versioduo/express/hardware/README.md

# express
🎚️ MIDI Expression Controller

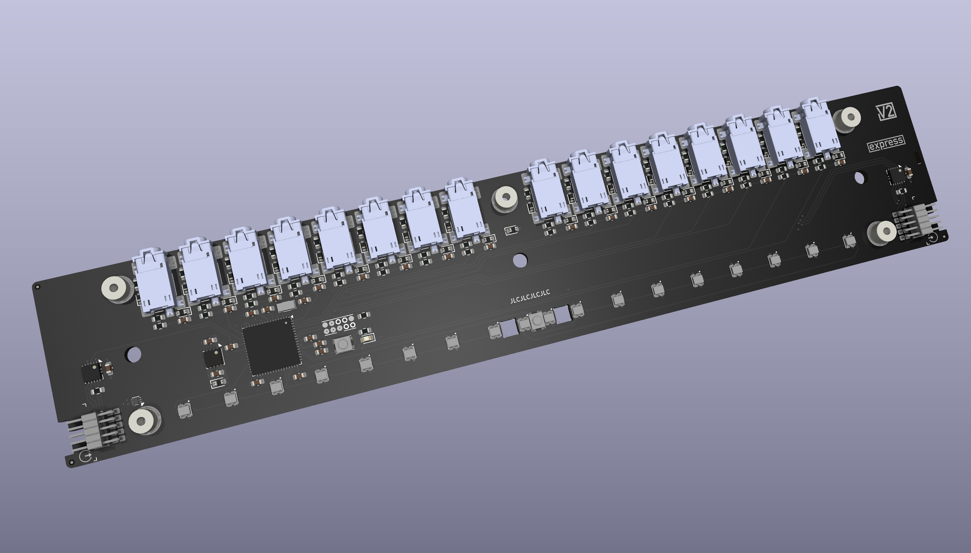
[picture p1: hardware/express-board.png]
board


## Schematic
[PDF](express.pdf)

## Bill Of Materials
[Interactive BOM](https://html-preview.github.io/?url=https://github.com/versioduo/express/main/hardware/express-bom.html)

# Copying
Anyone can use this public domain work without having to seek authorisation, no one can ever own it.
