versioduo/express/hardware/express.kicad_pcb

## KiCad design hardware/express.kicad_pcb (2026-04-15)

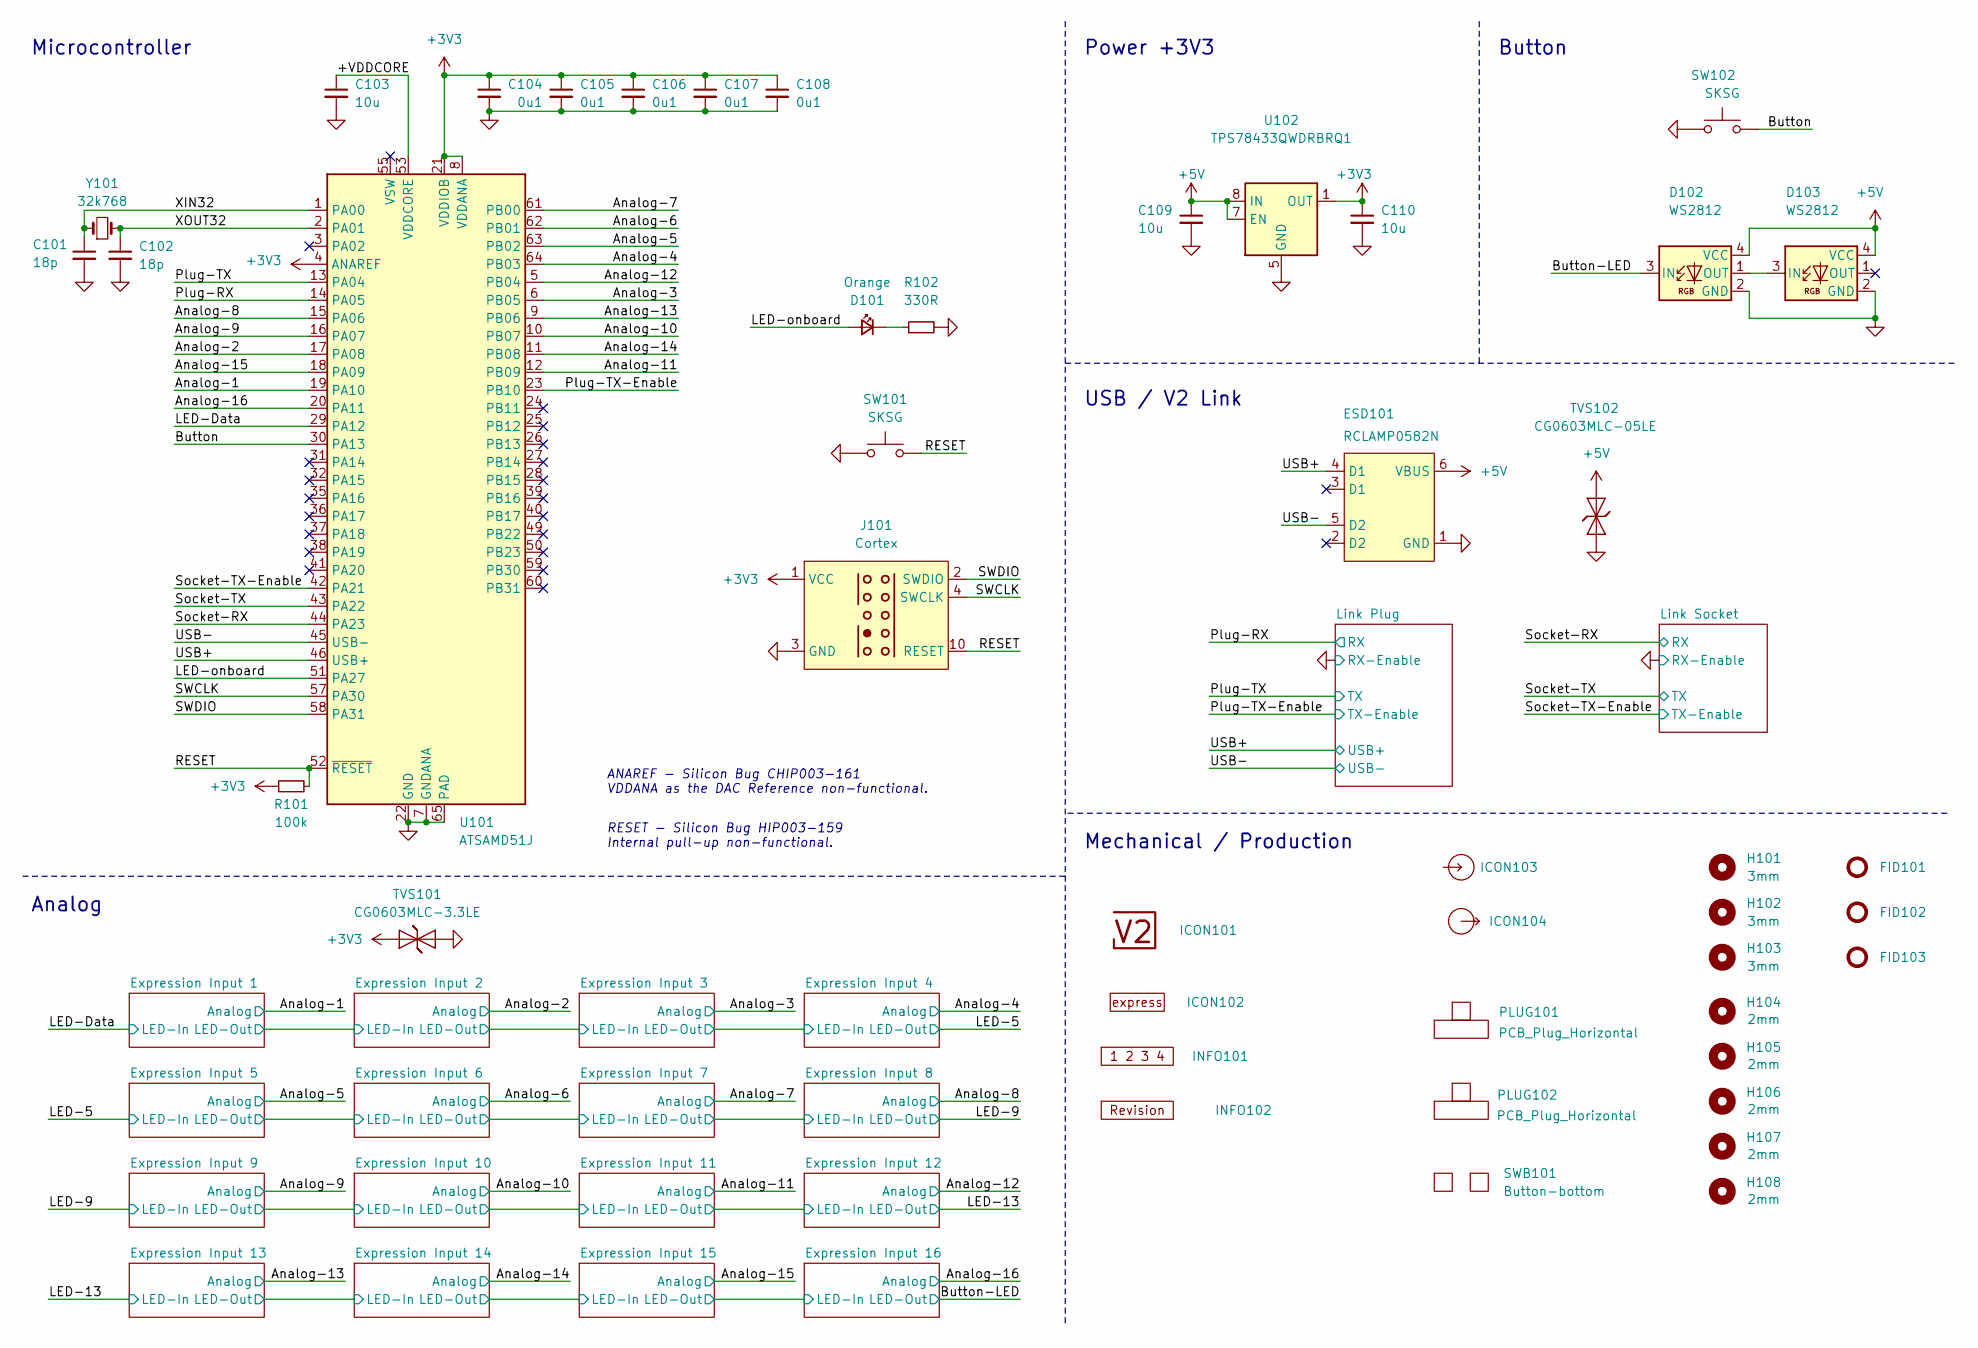
[picture p22: schematic express.kicad_sch, V2 express]

Parts:
C101, C102: 18p; C_0603; Rating 50V; Mouser 810-CGA3E2C0G1H180J
C103: 10u; C_0603; Rating 10V; Mouser 810-C1608X6S1A106M
C104, C105, C106, C107, C108: 0u1; C_0603; Rating 50V; Mouser 810-CGA3E2X7R1H104MA
C109, C110: 10u; C_0805; Rating 25V; Mouser 810-C2012X5R1E106K
D101: Orange; LED_0603; Rating 605nm; Mouser 755-SML-D12D1WT86
D102, D103: WS2812; WS2812-2020; Rating 15mA; LCSC C965555
ESD101: RCLAMP0582N; SLP1210N6; Rating 20kV; Mouser 947-RCLAMP0582N.TCT
FID101, FID102, FID103: Fiducial_Paste; Fiducial_0.5mm_Mask1mm_Paste
H101, H102, H103: 3mm; MountingHole_3mm
H104, H105, H106, H107, H108: 2mm; MountingHole_2mm
ICON101: V2-logo; Logo_Small
ICON102: Board_express; Board_express_Small
ICON103: Arrow_In
ICON104: Arrow_Out
INFO101: Layer_Numbers
INFO102: Revision
J101: Cortex
PLUG101, PLUG102: PCB_Plug_Horizontal
R101: 100k; R_0603; Rating 100mW; Mouser 71-CRCW0603100KFKEAC
R102: 330R; R_0603; Rating 100mW; Mouser 71-CRCW0603330RFKEAC
SW101, SW102: SKSG; Rating 1.6N; Mouser 688-SKSGACE010
SWB101: Button-bottom; PCB_Button-bottom
TVS101: CG0603MLC-3.3LE; D_0603; Rating 3V3; Mouser 652-CG0603MLC-3.3LE
TVS102: CG0603MLC-05LE; D_0603; Rating 5V; Mouser 652-CG0603MLC-05LE
U101: ATSAMD51J; QFN-64-1EP_9x9mm_P0.5mm_EP4.8x4.8mm_ThermalVias; Rating Cortex-M4F; Mouser 556-ATSAMD51J19AMU
U102: TPS78433QWDRBRQ1; VSON-8-1_3x3mm_P0.65_EP1.65x2.4mm; Rating 300mA; Mouser 595-TPS78433QWDRBRQ1
Y101: 32k768; Crystal_SMD_3215-2Pin_3.2x1.5mm; Rating 10ppm; Mouser 815-ABS0716632.768KT

Connections:
+3V3: C104.1, C105.1, C106.1, C107.1, C108.1, C110.1, J101.1 (VCC), R101.1, TVS101.1 (K), U101.4 (ANAREF), U101.8 (VDDANA), U101.21 (VDDIOB), U101.34 (VDDIO), U101.48 (VDDIO), U101.56 (VDDIO), U102.1 (OUT); also elsewhere on the board
+5V: C109.1, D102.4 (VCC), D103.4 (VCC), ESD101.6 (VBUS), TVS102.2 (A), U102.7 (EN), U102.8 (IN); also elsewhere on the board
/+VDDCORE: C103.1, U101.53 (VDDCORE)
/Analog-1: U101.19 (PA10); also elsewhere on the board
/Analog-2: U101.17 (PA08); also elsewhere on the board
/Analog-3: U101.6 (PB05); also elsewhere on the board
/Analog-4: U101.64 (PB03); also elsewhere on the board
/Analog-5: U101.63 (PB02); also elsewhere on the board
/Analog-6: U101.62 (PB01); also elsewhere on the board
/Analog-7: U101.61 (PB00); also elsewhere on the board
/Analog-8: U101.15 (PA06); also elsewhere on the board
/Analog-9: U101.16 (PA07); also elsewhere on the board
/Analog-10: U101.10 (PB07); also elsewhere on the board
/Analog-11: U101.12 (PB09); also elsewhere on the board
/Analog-12: U101.5 (PB04); also elsewhere on the board
/Analog-13: U101.9 (PB06); also elsewhere on the board
/Analog-14: U101.11 (PB08); also elsewhere on the board
/Analog-15: U101.18 (PA09); also elsewhere on the board
/Analog-16: U101.20 (PA11); also elsewhere on the board
/Button: SW102.2, U101.30 (PA13)
/Button-LED: D102.3 (IN); also elsewhere on the board
/LED-Data: U101.29 (PA12); also elsewhere on the board
/LED-onboard: D101.2 (A), U101.51 (PA27)
/Plug-RX: U101.14 (PA05); also elsewhere on the board
/Plug-TX: U101.13 (PA04); also elsewhere on the board
/Plug-TX-Enable: U101.23 (PB10); also elsewhere on the board
/RESET: J101.10 (RESET), R101.2, SW101.2, U101.52 (~RESET)
/SWCLK: J101.4 (SWCLK), U101.57 (PA30)
/SWDIO: J101.2 (SWDIO), U101.58 (PA31)
/Socket-RX: U101.44 (PA23); also elsewhere on the board
/Socket-TX: U101.43 (PA22); also elsewhere on the board
/Socket-TX-Enable: U101.42 (PA21); also elsewhere on the board
/USB+: ESD101.4 (D1), U101.46 (USB+); also elsewhere on the board
/USB-: ESD101.5 (D2), U101.45 (USB-); also elsewhere on the board
/XIN32: C101.1, U101.1 (PA00), Y101.1
/XOUT32: C102.1, U101.2 (PA01), Y101.2
GND: C101.2, C102.2, C103.2, C104.2, C105.2, C106.2, C107.2, C108.2, C109.2, C110.2, D102.2 (GND), D103.2 (GND), ESD101.1 (GND), J101.3 (GND), J101.5 (GND), R102.2, SW101.1, SW102.1, TVS101.2 (A), TVS102.1 (K), U101.7 (GNDANA), U101.22 (GND), U101.33 (GND), U101.47 (GND), U101.54 (GND), U101.65 (PAD), U102.5 (GND), U102.9 (GND); also elsewhere on the board
unnamed: D101.1 (K), R102.1
unnamed: D102.1 (OUT), D103.3 (IN)

Notes on the sheet:
ANAREF -  Silicon Bug CHIP003-161 VDDANA as the DAC Reference non-functional.
Analog
RESET -  Silicon Bug HIP003-159 Internal pull-up non-functional.
Button
Power +3V3
Mechanical / Production
Microcontroller
USB / V2 Link

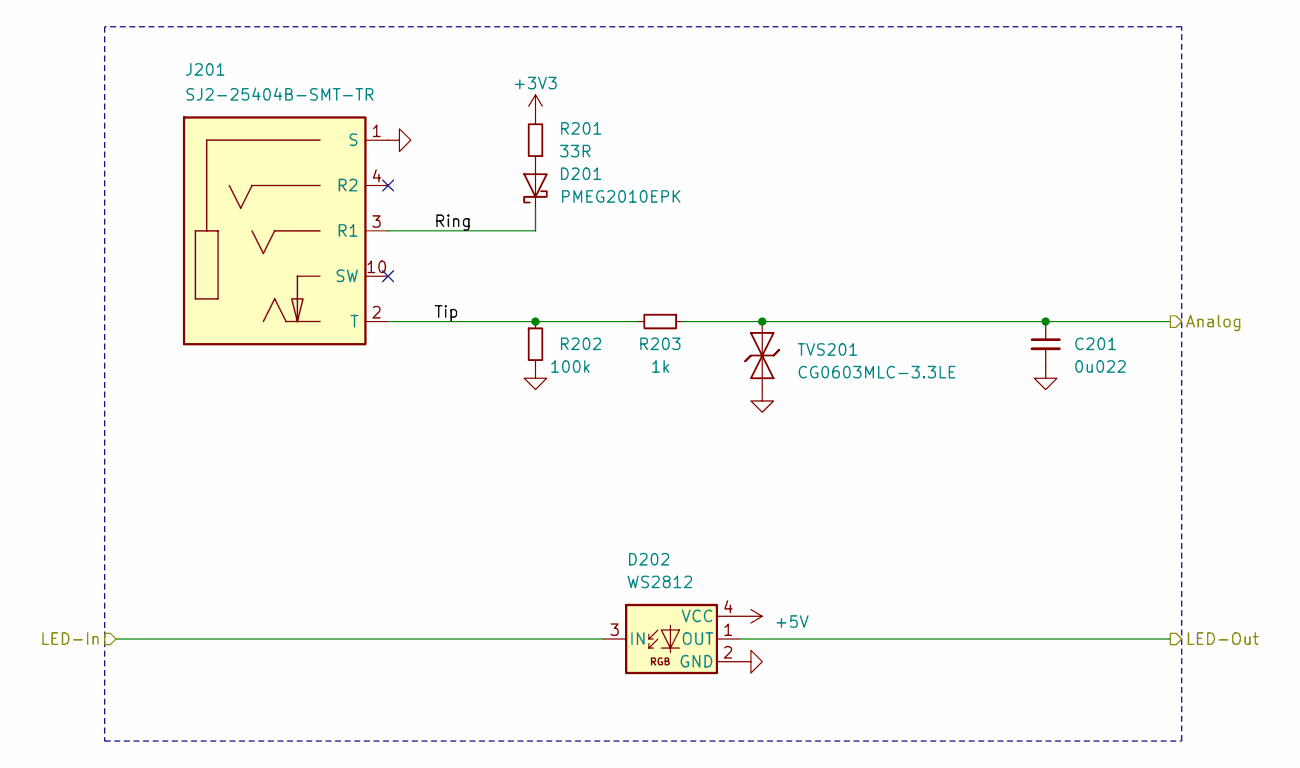
[picture p23: schematic ExpressionInput.kicad_sch, V2 express]

Parts:
C201: 0u022; C_0603; Rating 50V; Mouser 603-CC603KPX7R9BB223
D201: PMEG2010EPK; D_SOD-1608; Rating 20V; Mouser 771-PMEG2010EPK
D202: WS2812; WS2812-2020; Rating 15mA; LCSC C965555
J201: SJ2-25404B-SMT-TR; CUI_SJ2-25404B-SMT-TR; Rating 2.5mm; Mouser 490-SJ2-25404BSMT-TR
R201: 33R; R_0603; Rating 330mW; Mouser 71-CRCW060333R0FKEAH
R202: 100k; R_0603; Rating 100mW; Mouser 71-CRCW0603100KFKEAC
R203: 1k; R_0603; Rating 330mW; Mouser 71-CRCW06031K00FKEAH
TVS201: CG0603MLC-3.3LE; D_0603; Rating 3V3; Mouser 652-CG0603MLC-3.3LE

Connections:
+3V3: R201.2; also elsewhere on the board
+5V: D202.4 (VCC); also elsewhere on the board
/Analog-1: C201.1, R203.1, TVS201.2 (A); also elsewhere on the board
/Expression Input 1/LED-Out: D202.1 (OUT); also elsewhere on the board
/Expression Input 1/Ring: D201.1 (K), J201.3 (R1)
/Expression Input 1/Tip: J201.2 (T), R202.1, R203.2
/LED-Data: D202.3 (IN); also elsewhere on the board
GND: C201.2, D202.2 (GND), J201.1 (S), R202.2, TVS201.1 (K); also elsewhere on the board
unnamed: D201.2 (A), R201.1

Parts of its further copies:
C301, C401, C501, C601, C701, C801, C901, C1001, C1101, C1201, C1301, C1401, C1501, C1601, C1701: 0u022; C_0603; Rating 50V; Mouser 603-CC603KPX7R9BB223
D301, D401, D501, D601, D701, D801, D901, D1001, D1101, D1201, D1301, D1401, D1501, D1601, D1701: PMEG2010EPK; D_SOD-1608; Rating 20V; Mouser 771-PMEG2010EPK
D302, D402, D502, D602, D702, D802, D902, D1002, D1102, D1202, D1302, D1402, D1502, D1602, D1702: WS2812; WS2812-2020; Rating 15mA; LCSC C965555
J301, J401, J501, J601, J701, J801, J901, J1001, J1101, J1201, J1301, J1401, J1501, J1601, J1701: SJ2-25404B-SMT-TR; CUI_SJ2-25404B-SMT-TR; Rating 2.5mm; Mouser 490-SJ2-25404BSMT-TR
R301, R401, R501, R601, R701, R801, R901, R1001, R1101, R1201, R1301, R1401, R1501, R1601, R1701: 33R; R_0603; Rating 330mW; Mouser 71-CRCW060333R0FKEAH
R302, R402, R502, R602, R702, R802, R902, R1002, R1102, R1202, R1302, R1402, R1502, R1602, R1702: 100k; R_0603; Rating 100mW; Mouser 71-CRCW0603100KFKEAC
R303, R403, R503, R603, R703, R803, R903, R1003, R1103, R1203, R1303, R1403, R1503, R1603, R1703: 1k; R_0603; Rating 330mW; Mouser 71-CRCW06031K00FKEAH
TVS301, TVS401, TVS501, TVS601, TVS701, TVS801, TVS901, TVS1001, TVS1101, TVS1201, TVS1301, TVS1401, TVS1501, TVS1601, TVS1701: CG0603MLC-3.3LE; D_0603; Rating 3V3; Mouser 652-CG0603MLC-3.3LE

Connections of its further copies:
+3V3: R301.2, R401.2, R501.2, R601.2, R701.2, R801.2, R901.2, R1001.2, R1101.2, R1201.2, R1301.2, R1401.2, R1501.2, R1601.2, R1701.2; also elsewhere on the board
+5V: D302.4 (VCC), D402.4 (VCC), D502.4 (VCC), D602.4 (VCC), D702.4 (VCC), D802.4 (VCC), D902.4 (VCC), D1002.4 (VCC), D1102.4 (VCC), D1202.4 (VCC), D1302.4 (VCC), D1402.4 (VCC), D1502.4 (VCC), D1602.4 (VCC), D1702.4 (VCC); also elsewhere on the board
/Analog-2: C301.1, R303.1, TVS301.2 (A); also elsewhere on the board
/Analog-3: C401.1, R403.1, TVS401.2 (A); also elsewhere on the board
/Analog-4: C501.1, R503.1, TVS501.2 (A); also elsewhere on the board
/Analog-5: C601.1, R603.1, TVS601.2 (A); also elsewhere on the board
/Analog-6: C701.1, R703.1, TVS701.2 (A); also elsewhere on the board
/Analog-7: C801.1, R803.1, TVS801.2 (A); also elsewhere on the board
/Analog-8: C901.1, R903.1, TVS901.2 (A); also elsewhere on the board
/Analog-9: C1001.1, R1003.1, TVS1001.2 (A); also elsewhere on the board
/Analog-10: C1101.1, R1103.1, TVS1101.2 (A); also elsewhere on the board
/Analog-11: C1201.1, R1203.1, TVS1201.2 (A); also elsewhere on the board
/Analog-12: C1301.1, R1303.1, TVS1301.2 (A); also elsewhere on the board
/Analog-13: C1401.1, R1403.1, TVS1401.2 (A); also elsewhere on the board
/Analog-14: C1501.1, R1503.1, TVS1501.2 (A); also elsewhere on the board
/Analog-15: C1601.1, R1603.1, TVS1601.2 (A); also elsewhere on the board
/Analog-16: C1701.1, R1703.1, TVS1701.2 (A); also elsewhere on the board
/Button-LED: D1702.1 (OUT); also elsewhere on the board
/Expression Input 1/LED-Out: D302.3 (IN); also elsewhere on the board
/Expression Input 2/LED-Out: D302.1 (OUT), D402.3 (IN)
/Expression Input 2/Ring: D301.1 (K), J301.3 (R1)
/Expression Input 2/Tip: J301.2 (T), R302.1, R303.2
/Expression Input 3/LED-Out: D402.1 (OUT), D502.3 (IN)
/Expression Input 3/Ring: D401.1 (K), J401.3 (R1)
/Expression Input 3/Tip: J401.2 (T), R402.1, R403.2
/Expression Input 4/Ring: D501.1 (K), J501.3 (R1)
/Expression Input 4/Tip: J501.2 (T), R502.1, R503.2
/Expression Input 5/LED-Out: D602.1 (OUT), D702.3 (IN)
/Expression Input 5/Ring: D601.1 (K), J601.3 (R1)
/Expression Input 5/Tip: J601.2 (T), R602.1, R603.2
/Expression Input 6/LED-Out: D702.1 (OUT), D802.3 (IN)
/Expression Input 6/Ring: D701.1 (K), J701.3 (R1)
/Expression Input 6/Tip: J701.2 (T), R702.1, R703.2
/Expression Input 7/LED-Out: D802.1 (OUT), D902.3 (IN)
/Expression Input 7/Ring: D801.1 (K), J801.3 (R1)
/Expression Input 7/Tip: J801.2 (T), R802.1, R803.2
/Expression Input 8/Ring: D901.1 (K), J901.3 (R1)
/Expression Input 8/Tip: J901.2 (T), R902.1, R903.2
/Expression Input 9/Ring: D1001.1 (K), J1001.3 (R1)
/Expression Input 9/Tip: J1001.2 (T), R1002.1, R1003.2
/Expression Input 10/LED-In: D1002.1 (OUT), D1102.3 (IN)
/Expression Input 10/LED-Out: D1102.1 (OUT), D1202.3 (IN)
/Expression Input 10/Ring: D1101.1 (K), J1101.3 (R1)
/Expression Input 10/Tip: J1101.2 (T), R1102.1, R1103.2
/Expression Input 11/LED-Out: D1202.1 (OUT), D1302.3 (IN)
/Expression Input 11/Ring: D1201.1 (K), J1201.3 (R1)
/Expression Input 11/Tip: J1201.2 (T), R1202.1, R1203.2
/Expression Input 12/Ring: D1301.1 (K), J1301.3 (R1)
/Expression Input 12/Tip: J1301.2 (T), R1302.1, R1303.2
/Expression Input 13/LED-Out: D1402.1 (OUT), D1502.3 (IN)
/Expression Input 13/Ring: D1401.1 (K), J1401.3 (R1)
/Expression Input 13/Tip: J1401.2 (T), R1402.1, R1403.2
/Expression Input 14/LED-Out: D1502.1 (OUT), D1602.3 (IN)
/Expression Input 14/Ring: D1501.1 (K), J1501.3 (R1)
/Expression Input 14/Tip: J1501.2 (T), R1502.1, R1503.2
/Expression Input 15/LED-Out: D1602.1 (OUT), D1702.3 (IN)
/Expression Input 15/Ring: D1601.1 (K), J1601.3 (R1)
/Expression Input 15/Tip: J1601.2 (T), R1602.1, R1603.2
/Expression Input 16/Ring: D1701.1 (K), J1701.3 (R1)
/Expression Input 16/Tip: J1701.2 (T), R1702.1, R1703.2
/LED-5: D502.1 (OUT), D602.3 (IN)
/LED-9: D902.1 (OUT), D1002.3 (IN)
/LED-13: D1302.1 (OUT), D1402.3 (IN)
GND: C301.2, C401.2, C501.2, C601.2, C701.2, C801.2, C901.2, C1001.2, C1101.2, C1201.2, C1301.2, C1401.2, C1501.2, C1601.2, C1701.2, D302.2 (GND), D402.2 (GND), D502.2 (GND), D602.2 (GND), D702.2 (GND), D802.2 (GND), D902.2 (GND), D1002.2 (GND), D1102.2 (GND), D1202.2 (GND), D1302.2 (GND), D1402.2 (GND), D1502.2 (GND), D1602.2 (GND), D1702.2 (GND), J301.1 (S), J401.1 (S), J501.1 (S), J601.1 (S), J701.1 (S), J801.1 (S), J901.1 (S), J1001.1 (S), J1101.1 (S), J1201.1 (S), J1301.1 (S), J1401.1 (S), J1501.1 (S), J1601.1 (S), J1701.1 (S), R302.2, R402.2, R502.2, R602.2, R702.2, R802.2, R902.2, R1002.2, R1102.2, R1202.2, R1302.2, R1402.2, R1502.2, R1602.2, R1702.2, TVS301.1 (K), TVS401.1 (K), TVS501.1 (K), TVS601.1 (K), TVS701.1 (K), TVS801.1 (K), TVS901.1 (K), TVS1001.1 (K), TVS1101.1 (K), TVS1201.1 (K), TVS1301.1 (K), TVS1401.1 (K), TVS1501.1 (K), TVS1601.1 (K), TVS1701.1 (K); also elsewhere on the board
unnamed: D301.2 (A), R301.1
unnamed: D401.2 (A), R401.1
unnamed: D501.2 (A), R501.1
unnamed: D601.2 (A), R601.1
unnamed: D701.2 (A), R701.1
unnamed: D801.2 (A), R801.1
unnamed: D901.2 (A), R901.1
unnamed: D1001.2 (A), R1001.1
unnamed: D1101.2 (A), R1101.1
unnamed: D1201.2 (A), R1201.1
unnamed: D1301.2 (A), R1301.1
unnamed: D1401.2 (A), R1401.1
unnamed: D1501.2 (A), R1501.1
unnamed: D1601.2 (A), R1601.1
unnamed: D1701.2 (A), R1701.1

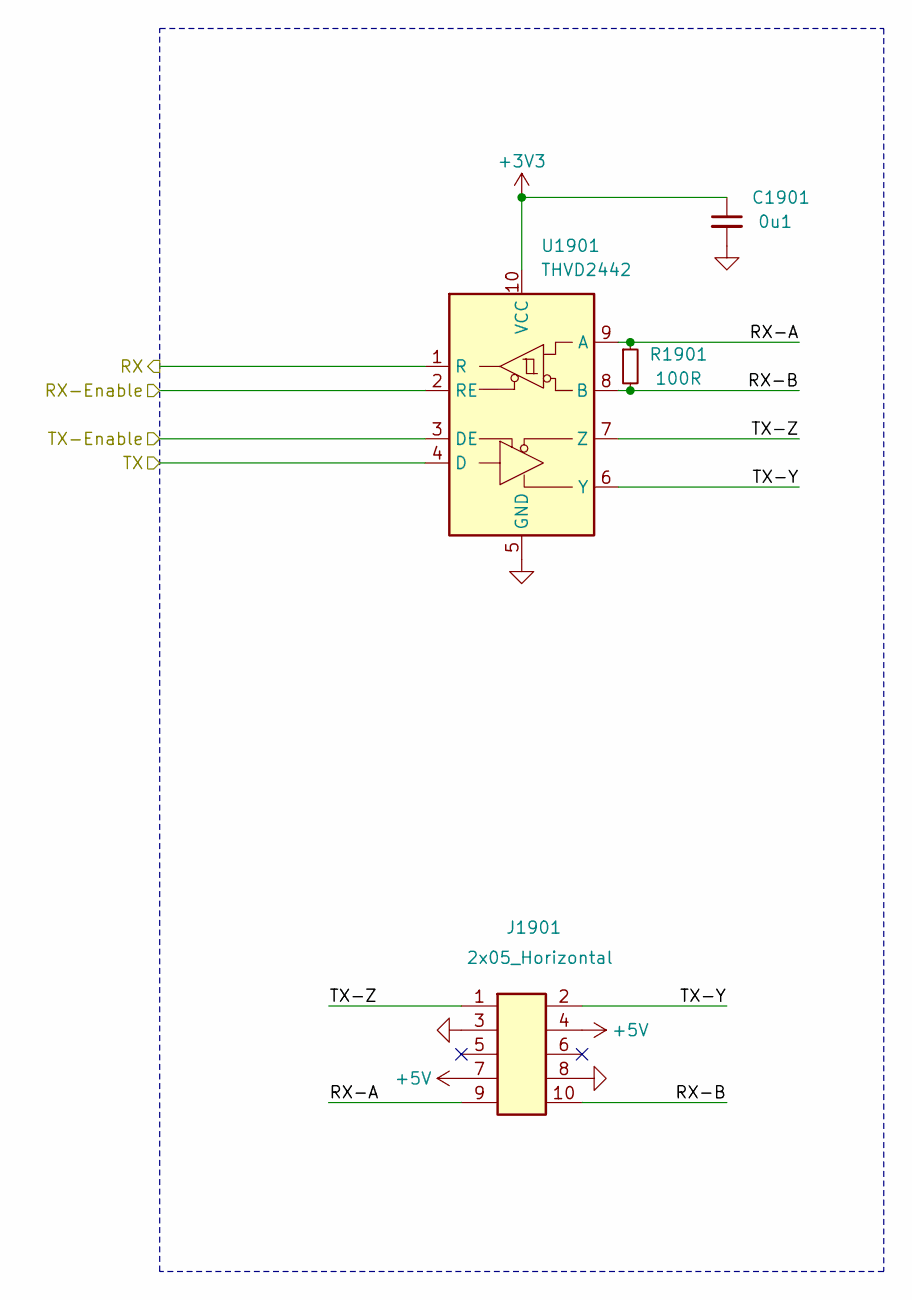
[picture p24: schematic LinkSocket.kicad_sch, V2 express]

Parts:
C1901: 0u1; C_0603; Rating 50V; Mouser 810-CGA3E2X7R1H104MA
J1901: 2x05_Horizontal; PinHeader_2x05_P1.27mm_Horizontal; Rating 1A; Mouser 649-200211120001T4LF
R1901: 100R; R_0603; Rating 330mW; Mouser 71-CRCW0603100RFKEAH
U1901: THVD2442; VSON-10-4-1EP_3x3mm_P0.5mm_EP1.65x2.4mm_ThermalVias; Rating 20Mbps; Mouser 595-THVD2442DRCR

Connections:
+3V3: C1901.1, U1901.10 (VCC); also elsewhere on the board
+5V: J1901.4, J1901.7; also elsewhere on the board
/Link Socket/RX-A: J1901.9, R1901.1, U1901.9 (A)
/Link Socket/RX-B: J1901.10, R1901.2, U1901.8 (B)
/Link Socket/TX-Y: J1901.2, U1901.6 (Y)
/Link Socket/TX-Z: J1901.1, U1901.7 (Z)
/Socket-RX: U1901.1 (R); also elsewhere on the board
/Socket-TX: U1901.4 (D); also elsewhere on the board
/Socket-TX-Enable: U1901.3 (DE); also elsewhere on the board
GND: C1901.2, J1901.3, J1901.8, U1901.2 (RE), U1901.5 (GND), U1901.11 (GND); also elsewhere on the board

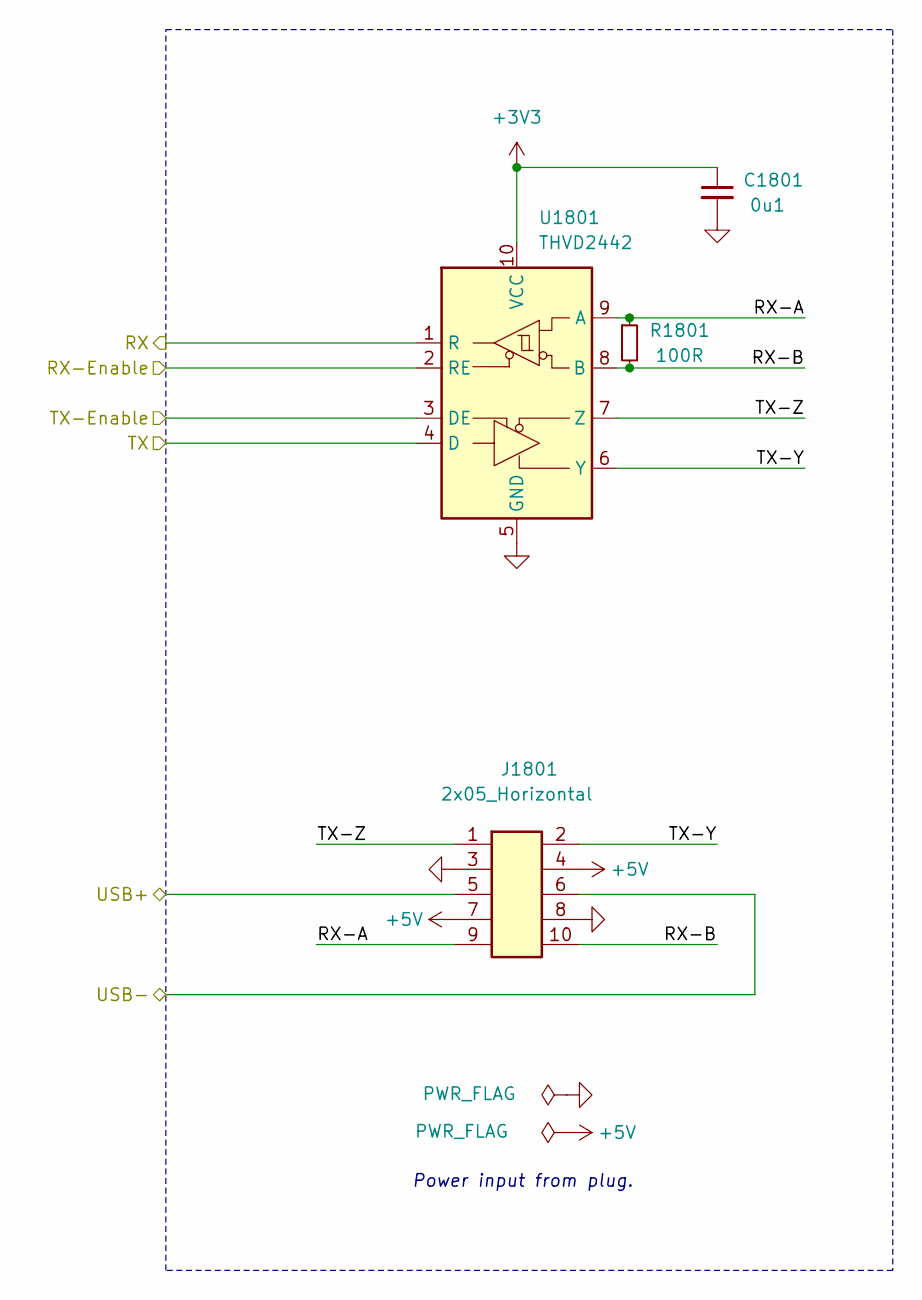
[picture p25: schematic LinkPlug.kicad_sch, V2 express]

Parts:
C1801: 0u1; C_0603; Rating 50V; Mouser 810-CGA3E2X7R1H104MA
J1801: 2x05_Horizontal; PinHeader_2x05_P1.27mm_Horizontal; Rating 1A; Mouser 649-200211120001T4LF
R1801: 100R; R_0603; Rating 330mW; Mouser 71-CRCW0603100RFKEAH
U1801: THVD2442; VSON-10-4-1EP_3x3mm_P0.5mm_EP1.65x2.4mm_ThermalVias; Rating 20Mbps; Mouser 595-THVD2442DRCR

Connections:
+3V3: C1801.1, U1801.10 (VCC); also elsewhere on the board
+5V: J1801.4, J1801.7; also elsewhere on the board
/Link Plug/RX-A: J1801.9, R1801.1, U1801.9 (A)
/Link Plug/RX-B: J1801.10, R1801.2, U1801.8 (B)
/Link Plug/TX-Y: J1801.2, U1801.6 (Y)
/Link Plug/TX-Z: J1801.1, U1801.7 (Z)
/Plug-RX: U1801.1 (R); also elsewhere on the board
/Plug-TX: U1801.4 (D); also elsewhere on the board
/Plug-TX-Enable: U1801.3 (DE); also elsewhere on the board
/USB+: J1801.5; also elsewhere on the board
/USB-: J1801.6; also elsewhere on the board
GND: C1801.2, J1801.3, J1801.8, U1801.2 (RE), U1801.5 (GND), U1801.11 (GND); also elsewhere on the board

Notes on the sheet:
Power input from plug.

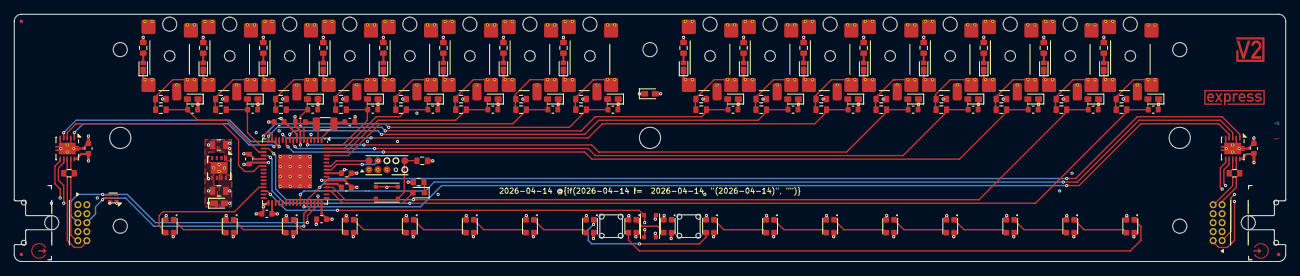
[picture p26: board express.kicad_pcb from above]

Board: 4 copper layers, 180.0 x 35.0 mm, 180 parts (0 on the bottom side), 110 nets.
