versioduo/express/(commit log)

2026-02-13 Replace Order_Number
    [ExpressionInput.kicad_sch, LinkPlug.kicad_sch, LinkSocket.kicad_sch, express-cover.kicad_pcb, express-cover.kicad_sch, express.kicad_pcb, express.kicad_sch]
2026-02-15 Update Library
    [ExpressionInput.kicad_sch, LinkPlug.kicad_sch, LinkSocket.kicad_sch, express-cover.kicad_pcb, express-cover.kicad_sch, express.kicad_pcb, express.kicad_sch]
2026-03-14 Update ESD suppressor
    [ExpressionInput.kicad_sch, LinkPlug.kicad_sch, LinkSocket.kicad_sch, express.kicad_pcb, express.kicad_sch]
2026-03-30 Replace diode
    [ExpressionInput.kicad_sch, LinkPlug.kicad_sch, LinkSocket.kicad_sch, express.kicad_pcb, express.kicad_sch]
2026-05-11 Good Bye Imperial
    [ExpressionInput.kicad_sch, LinkPlug.kicad_sch, LinkSocket.kicad_sch, express.kicad_sch]
